anugerahilahi2211/cold-brew-pid-cooling-system/README.md

# cold-brew-pid-cooling-system
An ESP32-based automatic cooling system developed to regulate the temperature and extraction duration of cold brew coffee using thermoelectric (Peltier) cooling and closed-loop PID control.
