anugerahilahi2211/cold-brew-pid-cooling-system/cold-brew-pid-cooling-system/FILES.md

# File Manifest

- `.gitignore` — 208 bytes
- `PORTFOLIO_NOTES.md` — 1,908 bytes
- `README.md` — 9,528 bytes
- `dashboard/dashboard.html` — 6,466 bytes
- `dashboard/index.html` — 6,466 bytes
- `data/closed-loop-15C.xlsx` — 11,806 bytes
- `data/closed-loop-5C.xlsx` — 381,538 bytes
- `data/closed-loop-8C.xlsx` — 148,171 bytes
- `data/open-loop-TL-analysis.xlsx` — 18,327 bytes
- `docs/MQTT-dashboard-setup-ID.txt` — 1,531 bytes
- `docs/thesis-report.pdf` — 3,276,020 bytes
- `firmware/cold_brew_pid_mqtt_controller.ino` — 36,720 bytes
- `hardware/3d-design.png` — 94,125 bytes
- `images/prototype.jpg` — 246,570 bytes
- `results/closed-loop-15C.png` — 70,599 bytes
- `results/closed-loop-5C.png` — 72,603 bytes
- `results/closed-loop-8C.png` — 67,993 bytes
- `results/open-loop-response.png` — 61,096 bytes
